sidorovsergei-source/-/DESIGN-NOTES.md

# История решений

1. Исходный запрос: удлиняемый чехол для лезвия и чертёж в четырёх видах. Первый иллюстративный вариант имел условный диапазон 250–330 мм и телескопическую фиксацию; эти размеры не приняты как требования.
2. Пользователь указал изготовление на 3D-принтере. Обсуждались две секции, сменные вставки и фиксация штифтом.
3. Требование расширено до хоккейных, фигурных, детских и вратарских коньков; одних изменений длины недостаточно для универсальной посадки.
4. Назначение уточнено: ходьба, масса пользователя до 130 кг, принтер Ender 3 Pro, последующая продажа.
5. Для прототипа предложена модульная конструкция с металлическими несущими направляющими, корпусом PETG, вставками TPU, резиновой подошвой и удерживающей перемычкой. Прочность не рассчитана и не испытана.
6. Пользователь задал максимум 38 см. В последующих эскизах принят максимум длины лезвия 380 мм, а не внешний габарит чехла.
7. Пользователь предоставил золотой логотип с коронованной головой волка и надписью «Си Ко». В последний эскиз добавлены логотип и место для сменного номера игрока (88 — пример).
8. Пользователь попросил сохранить всё в GitHub. В репозиторий включены доступные PNG и документация; отсутствующие исходники не восстановлены и не подменены новыми изображениями.

9. По запросу пользователя разработан печатный параметрический прототип v0.1 под Ender 3 Pro. Максимальная сборка: две секции 150 мм и средняя 100 мм, наружная длина 400 мм, внутренний размер 380 мм. Добавлены короткие секции 90 мм и средние 20–100 мм.
10. Вместо ещё не рассчитанного телескопического металлического стыка прототип использует две цельные полосы и сменные средние модули. Изменение длины требует другой пары полос. Это изменение явно отмечено; телескопическая функция остаётся для следующей версии.
11. Добавлены TPU-вставки с треугольными фиксирующими рёбрами и соответствующими пазами, пробные подошвы с механическим креплением, отдельные плашки логотипа и номера. Логотип упрощённо восстановлен для печати, исходного вектора нет.
12. При проверке сборки крепёж подошвы уточнён до M3×12: M3×14 мог выступать в основание вставки. STL проверены геометрически; физической печати, проверки посадки и нагрузки не было.

Эти заметки фиксируют обсуждение, а не подтверждают инженерную пригодность предложений.
