sidorovsergei-source/-/drawings/01-modular-guard-380mm.png

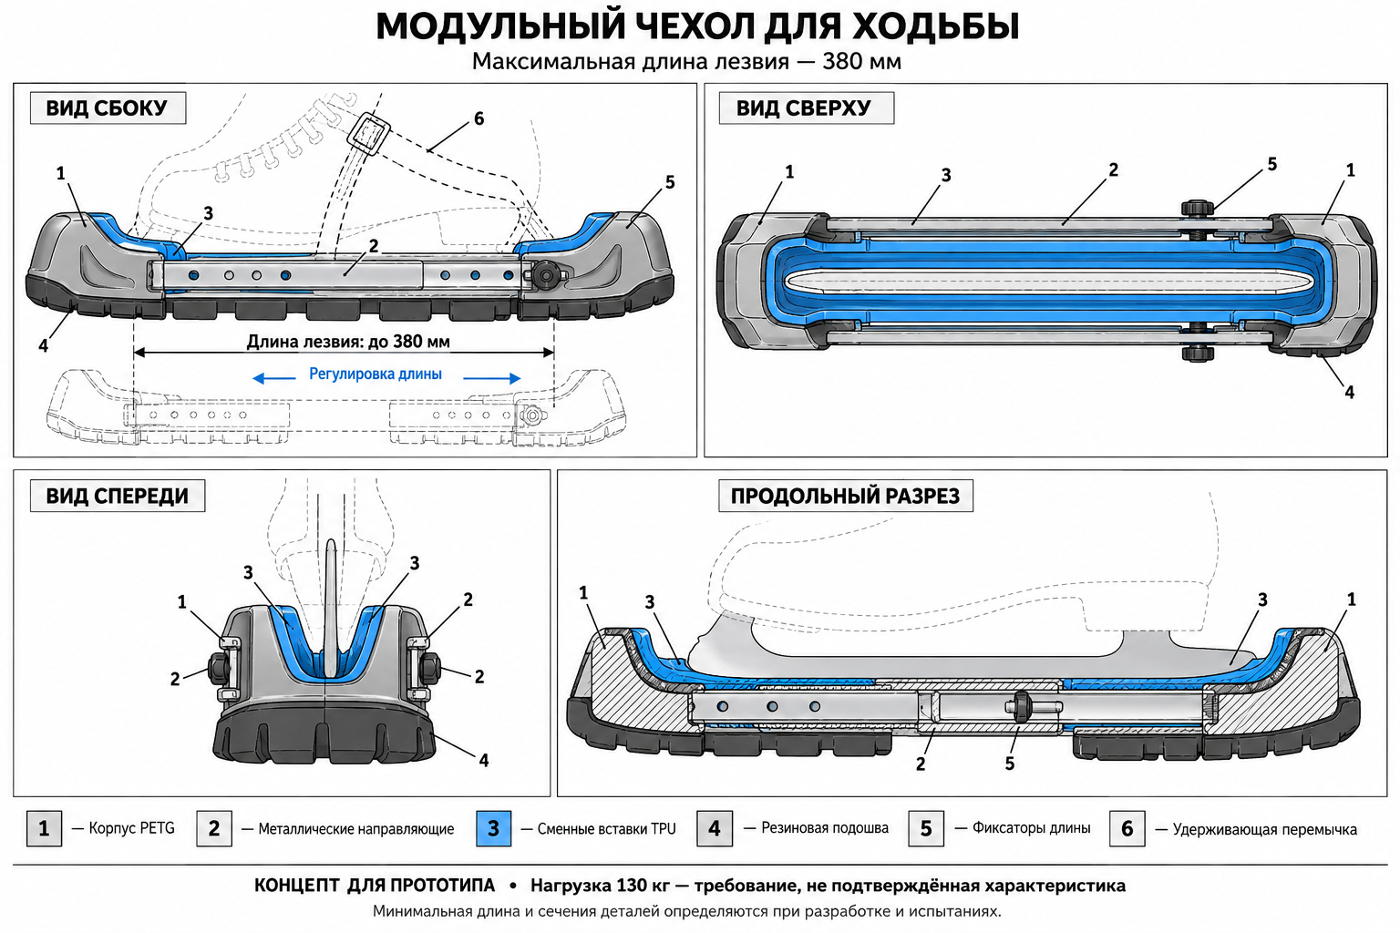
drawings/01-modular-guard-380mm.png
