sidorovsergei-source/-/stl/liner_long.stl

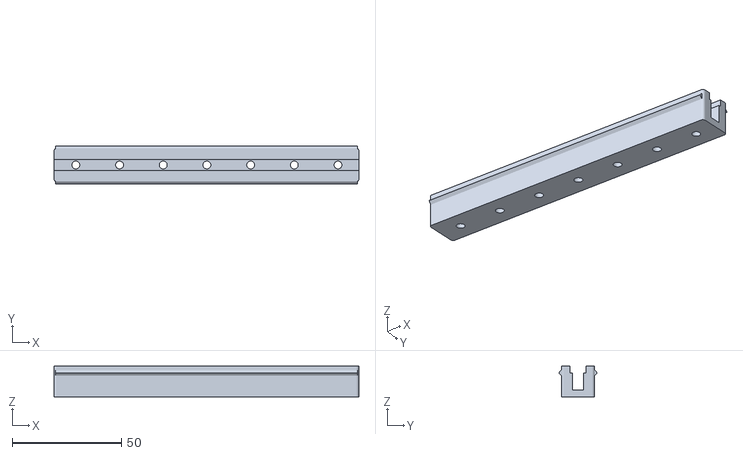
[picture p4: CAD file, 2026-10-10]
stl/liner_long.stl
139.6 x 17.6 x 14.0
