sidorovsergei-source/-/stl/center20.stl

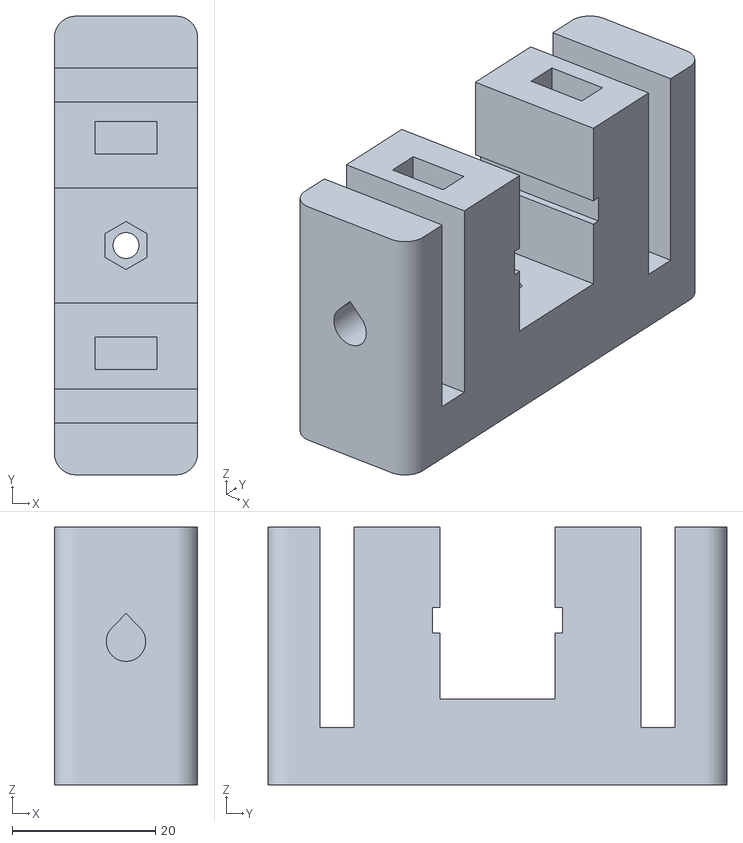
[picture p5: CAD file, 2026-10-10]
stl/center20.stl
20.0 x 64.0 x 36.0
