sidorovsergei-source/-/stl/center40.stl

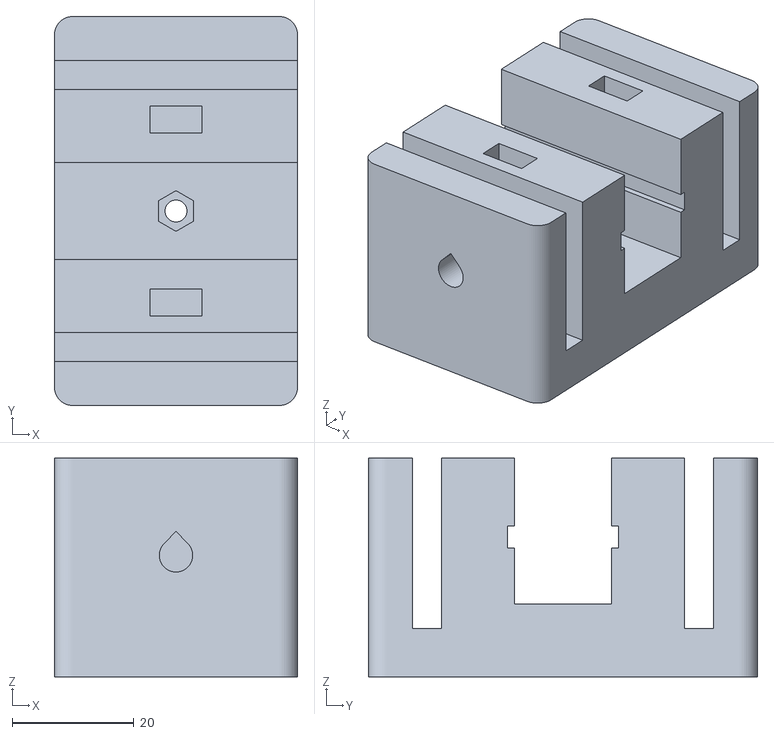
[picture p6: CAD file, 2026-10-10]
stl/center40.stl
40.0 x 64.0 x 36.0
