sidorovsergei-source/-/stl/liner20.stl

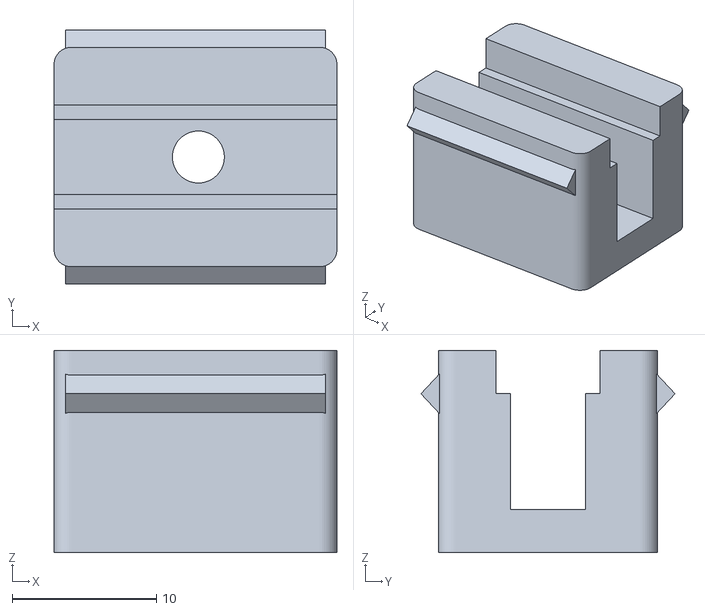
[picture p7: CAD file, 2026-10-10]
stl/liner20.stl
19.6 x 17.6 x 14.0
