sidorovsergei-source/-/stl/logo_badge.stl

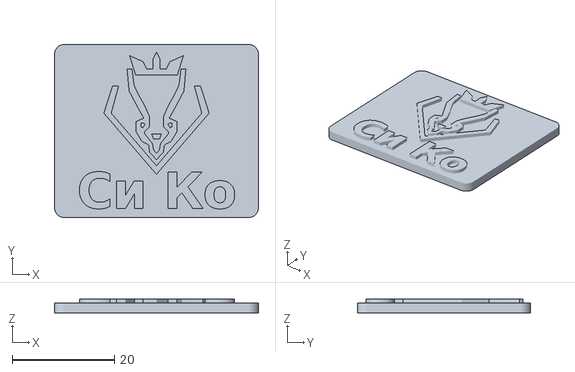
[picture p8: CAD file, 2026-10-10]
stl/logo_badge.stl
40.0 x 34.0 x 2.80
