sidorovsergei-source/-/stl/liner80.stl

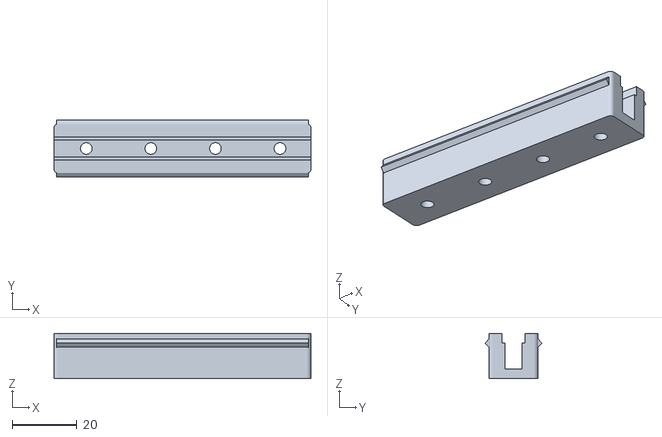
[picture p9: CAD file, 2026-10-10]
stl/liner80.stl
79.6 x 17.6 x 14.0
