sidorovsergei-source/-/stl/sole40.stl

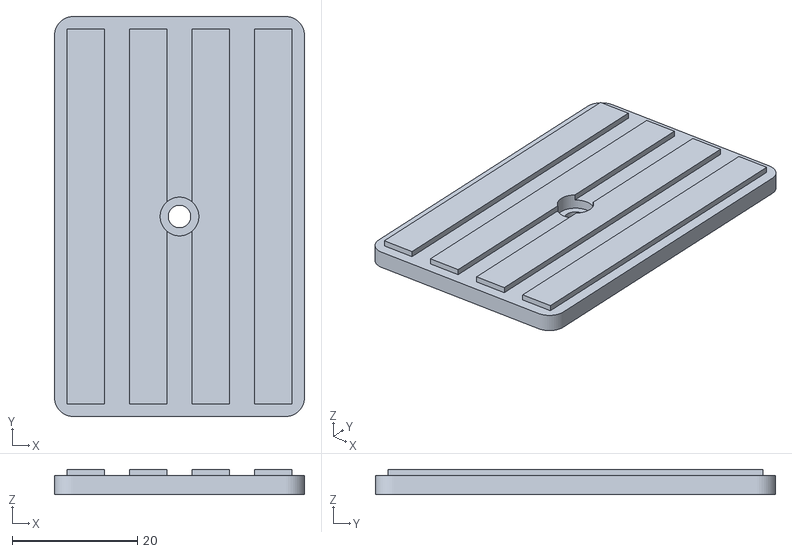
[picture p10: CAD file, 2026-10-10]
stl/sole40.stl
40.0 x 64.0 x 4.00
