sidorovsergei-source/-/stl/sole60.stl

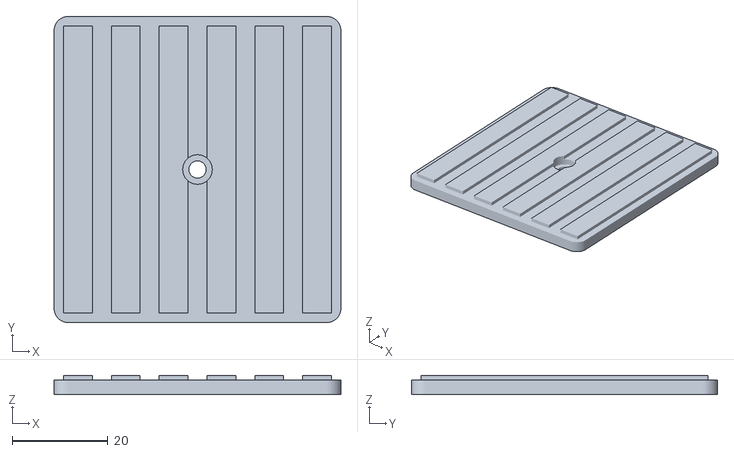
[picture p11: CAD file, 2026-10-10]
stl/sole60.stl
60.0 x 64.0 x 4.00
