sidorovsergei-source/-/stl/liner100.stl

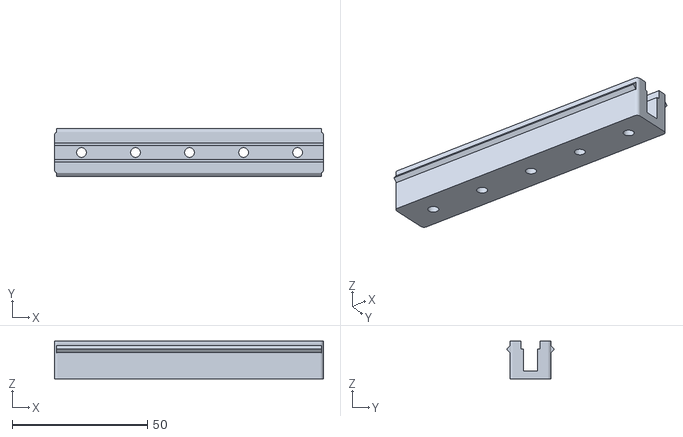
[picture p12: CAD file, 2026-10-10]
stl/liner100.stl
99.6 x 17.6 x 14.0
