sidorovsergei-source/-/stl/liner60.stl

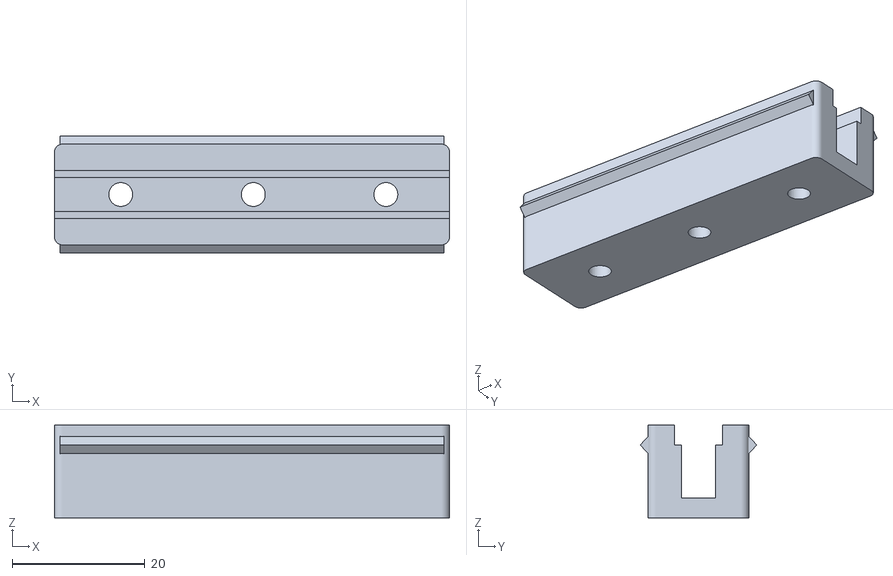
[picture p13: CAD file, 2026-10-10]
stl/liner60.stl
59.6 x 17.6 x 14.0
