sidorovsergei-source/-/stl/sole100.stl

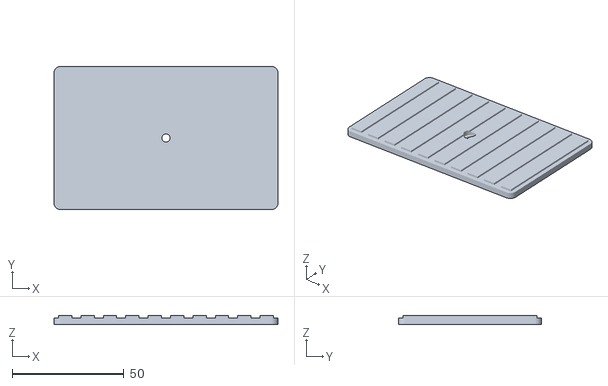
[picture p14: CAD file, 2026-10-10]
stl/sole100.stl
100.0 x 64.0 x 4.00
