sidorovsergei-source/-/stl/body_plate_380.stl

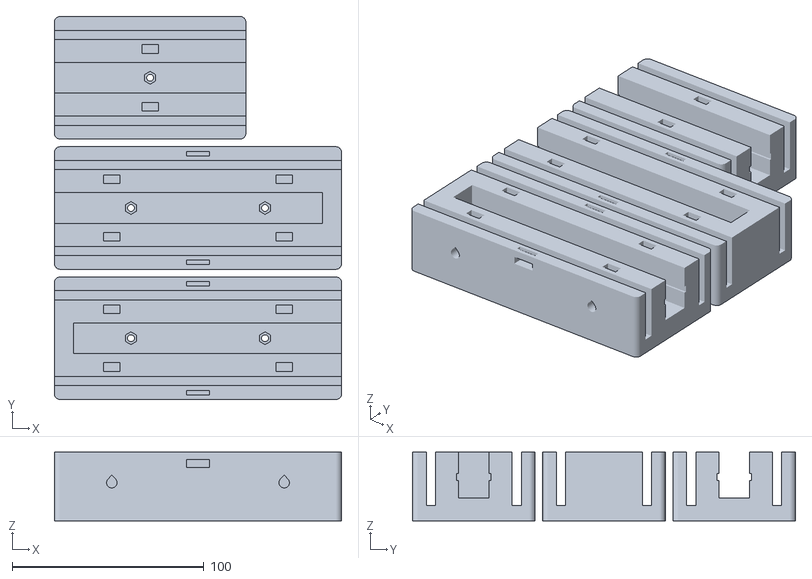
[picture p15: CAD file, 2026-10-10]
stl/body_plate_380.stl
150.0 x 200.0 x 36.0
