sidorovsergei-source/-/stl/center60.stl

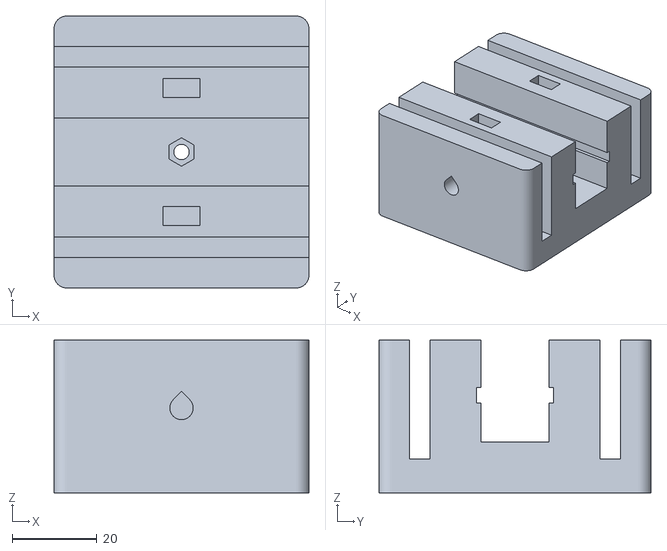
[picture p16: CAD file, 2026-10-10]
stl/center60.stl
60.0 x 64.0 x 36.0
