sidorovsergei-source/-/stl/sole20.stl

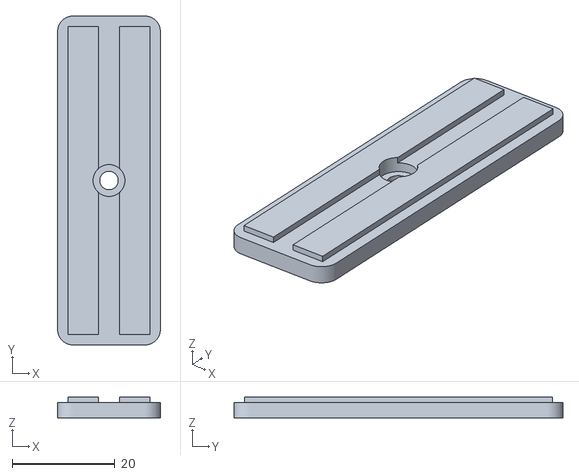
[picture p17: CAD file, 2026-10-10]
stl/sole20.stl
20.0 x 64.0 x 4.00
