sidorovsergei-source/-/stl/sole_long.stl

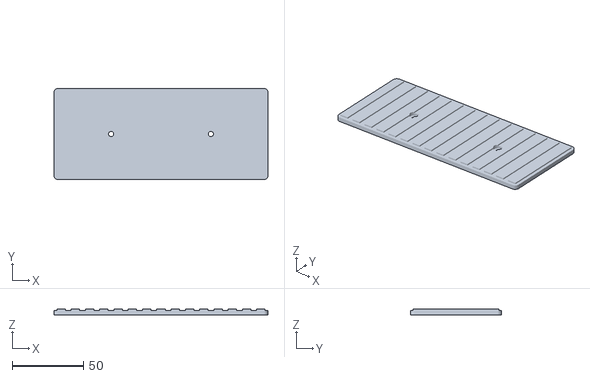
[picture p18: CAD file, 2026-10-10]
stl/sole_long.stl
150.0 x 64.0 x 4.00
