sidorovsergei-source/-/stl/toe_long.stl

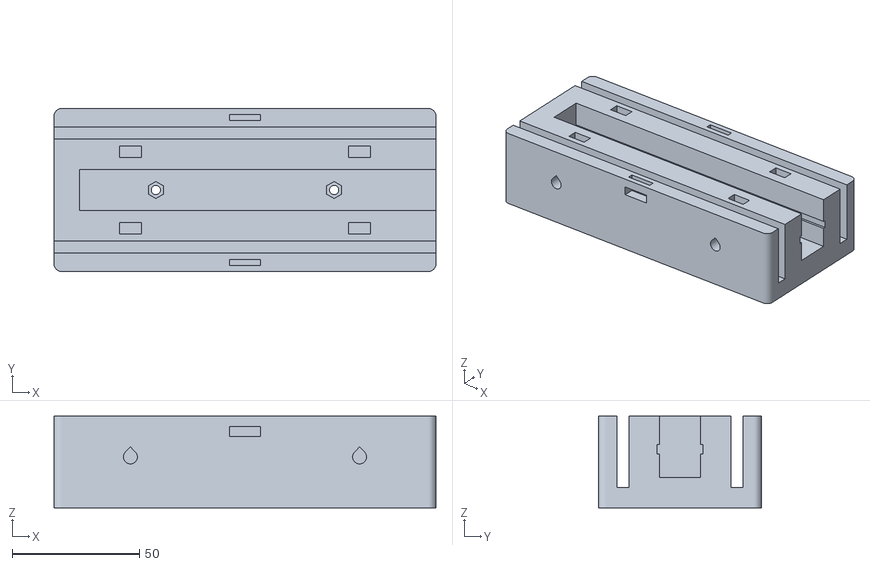
[picture p19: CAD file, 2026-10-10]
stl/toe_long.stl
150.0 x 64.0 x 36.0
