sidorovsergei-source/-/stl/center80.stl

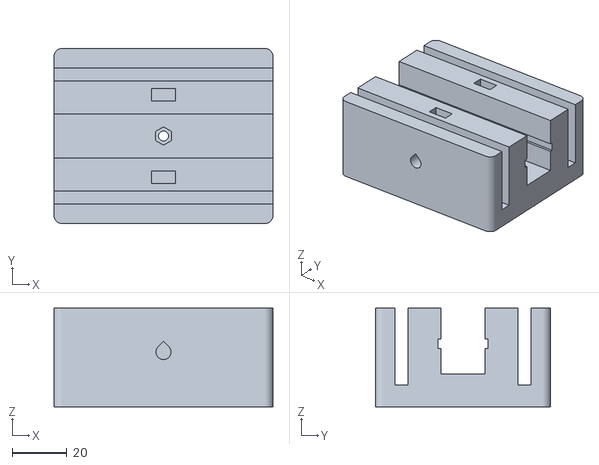
[picture p20: CAD file, 2026-10-10]
stl/center80.stl
80.0 x 64.0 x 36.0
