sidorovsergei-source/-/stl/toe_short.stl

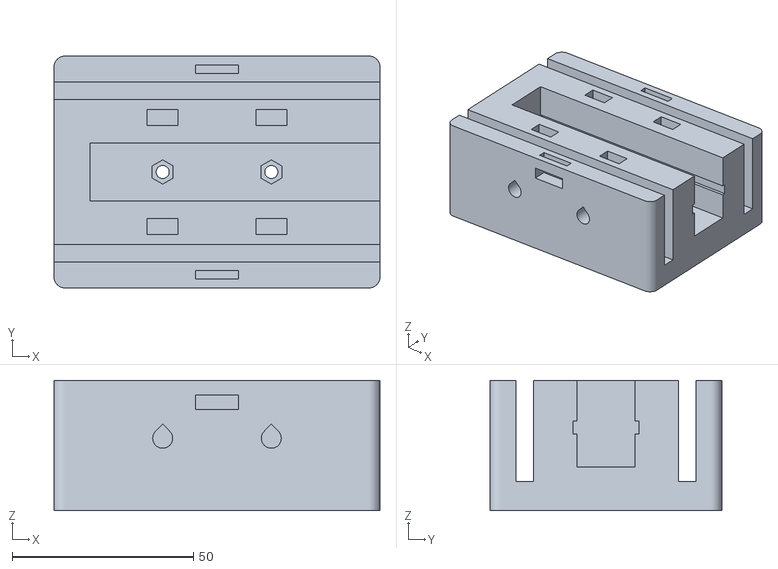
[picture p21: CAD file, 2026-10-10]
stl/toe_short.stl
90.0 x 64.0 x 36.0
