sidorovsergei-source/-/stl/number_badge.stl

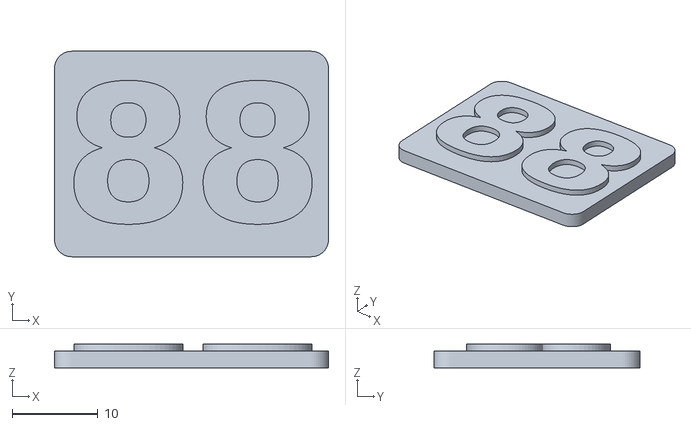
[picture p22: CAD file, 2026-10-10]
stl/number_badge.stl
32.0 x 24.0 x 2.80
