sidorovsergei-source/-/stl/center100.stl

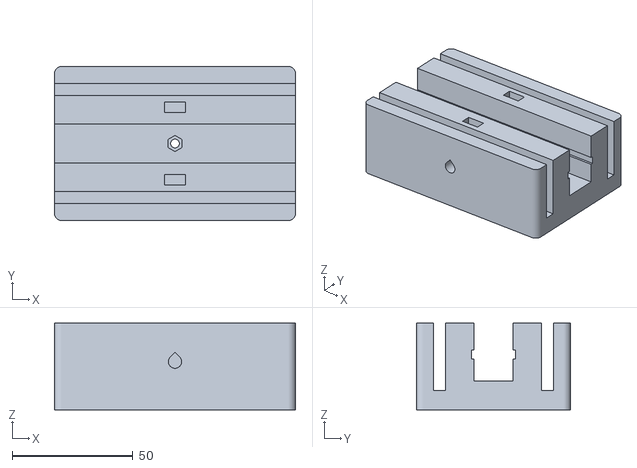
[picture p23: CAD file, 2026-10-10]
stl/center100.stl
100.0 x 64.0 x 36.0
