sidorovsergei-source/-/stl/sole_short.stl

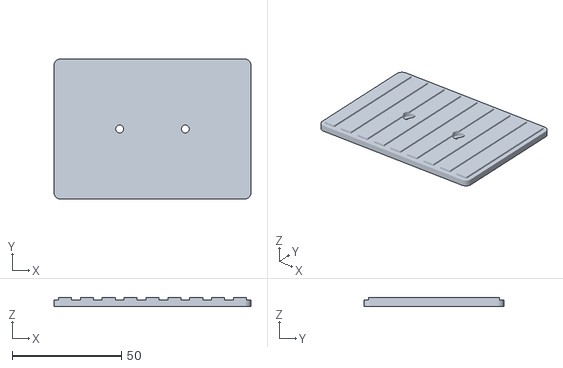
[picture p24: CAD file, 2026-10-10]
stl/sole_short.stl
90.0 x 64.0 x 4.00
