sidorovsergei-source/-/stl/liner40.stl

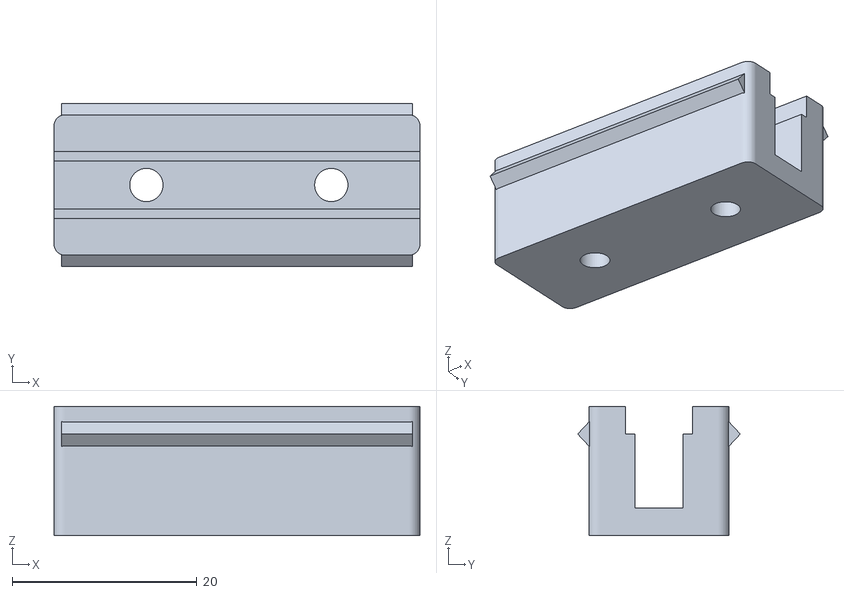
[picture p25: CAD file, 2026-10-10]
stl/liner40.stl
39.6 x 17.6 x 14.0
