sidorovsergei-source/-/stl/sole80.stl

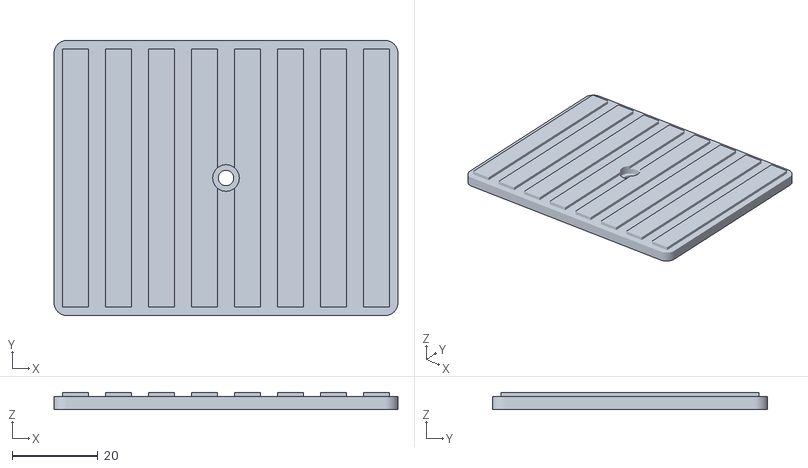
[picture p26: CAD file, 2026-10-10]
stl/sole80.stl
80.0 x 64.0 x 4.00
