sidorovsergei-source/-/(list of files, cad)

Other CAD files:
stl/fit_coupon.stl
stl/liner_short.stl
stl/heel_short.stl
stl/heel_long.stl
