sidorovsergei-source/-/PRINTING.md

# Печать прототипа на Ender 3 Pro

Модель предназначена для изготовления и проверки прототипа модульного чехла. Максимальная длина лезвия по заданию — 380 мм. Масса пользователя 130 кг и совместимость со всеми типами коньков остаются требованиями: испытаний готового изделия пока нет.

Длина меняется заменой средней секции и пары металлических полос соответствующей длины. Собранный чехол не раздвигается: телескопического соединения в этой версии нет. Номинальные внутренние размеры — 160–380 мм с шагом 20 мм; для конкретного лезвия необходимо проверить посадку и удержание, а не выбирать размер только по длине.

Печатные детали не заменяют металлические несущие направляющие, крепёж и подошву. До проверки собранного изделия на стенде не используйте прототип для ходьбы и не обозначайте его как проверенный товар для продажи.

## Принтер и подготовка

- Ender 3 Pro: номинальный объём 220 × 220 × 250 мм. Проверьте полезную область в профиле слайсера, положение прищепок и ограничения конкретной поверхности стола.
- Начальный профиль рассчитан на сопло 0,4 мм и филамент 1,75 мм. Для крупных деталей проверьте, что юбка или кайма также помещается на стол.
- Выставьте стол, проверьте первый слой и откалибруйте подачу филамента. Компенсацию расширения первого слоя подберите на небольшом образце, чтобы нижние края не мешали сборке.
- Просушите материалы по инструкции их производителя. Влажный PETG и TPU дают пузырьки и ухудшают качество поверхности и соединение слоёв.
- Проверьте реальную конструкцию хотэнда. У штатного Ender 3 Pro трубка PTFE обычно подходит к соплу: не превышайте температурные ограничения производителя хотэнда и трубки. Для этого прототипа выбирайте PETG, который печатается в разрешённом диапазоне; высокотемпературный нейлон и композиты требуют отдельной подготовки принтера.

## Комплект для одного чехла максимальной длины

| Деталь | Количество | Размер или назначение |
| --- | --- | --- |
| Длинная передняя секция PETG | 1 | [toe_long.stl](stl/toe_long.stl), 150 × 64 × 36 мм |
| Длинная задняя секция PETG | 1 | [heel_long.stl](stl/heel_long.stl), 150 × 64 × 36 мм |
| Средняя секция PETG | 1 | [center100.stl](stl/center100.stl), длина 100 мм; длина корпуса сборки без декора 400 мм |
| Вкладыши TPU 95A | 2 длинных и 1 средний | [liner_long.stl](stl/liner_long.stl) × 2 и [liner100.stl](stl/liner100.stl) × 1 |
| Подошвенные накладки TPU 95A | 2 длинных и 1 средняя | [sole_long.stl](stl/sole_long.stl) × 2 и [sole100.stl](stl/sole100.stl) × 1; общая толщина 4 мм: основание 3 мм и протектор 1 мм |
| Непрерывные стальные полосы | 2 | 4 × 25 × 376 мм, без острых кромок |
| Декоративные таблички | По желанию | [logo_badge.stl](stl/logo_badge.stl), 40 × 34 мм; [number_badge.stl](stl/number_badge.stl), 32 × 24 мм |
| Винты M5, квадратные гайки и шайбы | По 10 | Примерная длина винта M5 × 20 мм; проверить на фактических гайках и шайбах |
| Винты M3 с низкой полукруглой головкой и шестигранные гайки | По 5 | M3 × 12 мм для механического крепления подошвенных накладок; посадки выполнены под головку типа button head |
| Стропы с пряжками | По одной на торцевую секцию | Покупная стропа шириной 10 мм и толщиной не более 1,5 мм; длина по примерке на конкретном ботинке |

Для пары чехлов удвойте количество. Сечение полосы 4 × 25 мм — геометрический выбор для этого прототипа, а не подтверждённая спецификация для нагрузки 130 кг. Короткие варианты корпуса имеют длину 90 мм; сменные средние секции — 20, 40, 60, 80 и 100 мм. Длина полосы равна наружной длине собранного корпуса минус 24 мм. В торцах предусмотрено по 10 мм под упоры; внутренний продольный размер равен наружной длине минус 20 мм.

Посадочные места квадратных гаек M5 рассчитаны примерно на ширину гайки 8 мм и толщину 3 мм; ширина кармана 8,6 мм, его толщина 4,5 мм. Проверьте размеры реального крепежа до покупки всего комплекта. Винт должен полностью проходить гайку, но его конец не должен касаться вкладыша или лезвия.

Сначала напечатайте [fit_coupon.stl](stl/fit_coupon.stl) из PETG и [liner40.stl](stl/liner40.stl) из TPU. Образец воспроизводит реальные пазы под полосы, крепёж и канал вкладыша на средней секции длиной 40 мм. Проверьте его с обрезками полосы выбранного сечения и фактическими гайками; только после этого печатайте полный комплект.

Вкладыш фиксируется гибкими боковыми выступами в ответных канавках корпуса. Ширина основной посадочной части — 15,2 мм, максимальная ширина вместе с выступами — 17,6 мм. Выступы размещаются на высоте 9,5–12,5 мм от низа вкладыша; после установки им соответствуют канавки на высоте 21,2–24,8 мм от основания корпуса. Номинальный запас до наружной стенки канавки — 0,3 мм. Сначала проверьте защёлкивание и извлечение на пробном комплекте: TPU должен деформироваться упруго, а корпус не должен трескаться. Клей для вкладыша конструкцией не предусмотрен; фактическое удержание после повторной установки и при движении лезвия нужно подтвердить экспериментально.

Самая большая жёсткая деталь занимает 150 × 64 × 36 мм. Она помещается на номинальном столе Ender 3 Pro отдельно с каймой. Печатайте крупные корпуса по одному: это позволяет оценить качество и не потерять весь комплект при остановке печати.

После проверки отдельных деталей можно использовать [body_plate_380.stl](stl/body_plate_380.stl): это один STL с тремя раздельными жёсткими секциями для одного чехла на 380 мм. Габарит раскладки 150 × 200 × 36 мм; с каймой 5 мм — примерно 160 × 210 мм. Между деталями предусмотрено 4 мм: слайсер может объединить соседние каймы, после печати их нужно удалить. Печатайте всю раскладку только из PETG. Мягкие вкладыши и подошвы печатаются отдельно из TPU; файл раскладки не является готовым собранным чехлом.

## Материалы

| Детали | Материал | Что купить для первого комплекта |
| --- | --- | --- |
| Жёсткие части корпуса, декоративные таблички | PETG | Обычный PETG без наполнителя, чёрный; небольшой запас золотого PETG для декора |
| Мягкие вкладыши канала лезвия | TPU 95A | TPU с рекомендацией производителя для подачи Bowden |
| Пробная подошва | TPU 95A | STL-накладки для проверки геометрии и крепления |
| Подошва готового изделия | Материал с проверенным сцеплением | Включая возможную замену на подошвенную резину после разработки крепления и испытаний |
| Несущие направляющие и фиксаторы | Металл | По размерам и спецификации конкретной сборки; не печатать как замену металлическим деталям |

TPU 95A можно использовать для пробных мягких деталей. Его твёрдость и текстура сами по себе не подтверждают сцепление на мокром полу. PLA не используйте как материал ходового прототипа.

## Начальные настройки слайсера

Это отправная точка для настройки конкретного филамента и принтера, а не подтверждение несущей способности изделия.

| Параметр | PETG, корпус | TPU 95A, вкладыши и подошвы |
| --- | --- | --- |
| Диаметр сопла | 0,4 мм | 0,4 мм |
| Высота слоя | 0,20 мм | 0,20 мм |
| Ширина линии | 0,45–0,48 мм | 0,42–0,45 мм |
| Стенки | 6 линий | 4 линии |
| Верх и низ | Не менее 1,2–1,6 мм | Не менее 1,0 мм |
| Заполнение | 40–60%, gyroid или cubic | 100% для тонких деталей |
| Температура сопла | Начать с 230–235 °C, если разрешено для материала и хотэнда | По инструкции производителя TPU, в пределах возможностей хотэнда |
| Температура стола | Начать с 70 °C, с учётом допустимого режима поверхности | По инструкции производителя, обычно 40–60 °C |
| Скорость | 30–40 мм/с; внешние стенки 20–25 мм/с | 15–20 мм/с |
| Первый слой | 15–20 мм/с | 10–15 мм/с |
| Обдув | Слабый после первых слоёв, настроить по сцеплению слоёв | По инструкции производителя TPU |
| Ретракт | Откалиброванный для PETG и Bowden | Начать без ретракта, затем подобрать минимально необходимый |
| Адгезия к столу | При необходимости кайма 5–8 мм | При необходимости небольшая кайма |

Перед полноразмерной печатью проверьте посадку вкладыша, соединение корпуса и крепёж на небольшой пробной детали. Зазоры зависят от первого слоя, подачи и усадки; не уменьшайте сечения несущих участков для получения более свободной посадки.

PETG может слишком прочно прилипать к некоторым поверхностям. Используйте рекомендованный производителем разделительный слой и снимайте деталь после остывания стола.

На штатной системе подачи Bowden гибкий TPU может застревать и наматываться на шестерню. Для первого опыта используйте TPU 95A, снижайте скорость и давление прижимного ролика в допустимых пределах; более мягкий TPU не заменяет выбранный материал без повторной настройки и проверки.

## Ориентация и декоративные детали

Корпуса печатайте плоским основанием на столе, каналом для лезвия вверх. Вкладыши печатайте плоским низом вниз, открытым каналом вверх. Подошвенные накладки размещайте плоской поверхностью к столу, протектором вверх. Детали спроектированы для печати в этих ориентациях без поддержек; перед запуском проверьте мосты над боковыми отверстиями в предпросмотре. Не поворачивайте деталь только ради заполнения стола: изменение направления слоёв изменяет прочность.

Сменные таблички печатайте задней плоскостью на столе, рельефом вверх. Основа толщиной 2 мм, рельеф высотой 0,8 мм. Для золотого рельефа на чёрной основе используйте паузу и ручную замену PETG после печати основы, перед первым слоем рельефа выше 2 мм. Задавайте её по фактическому слою в предпросмотре слайсера; начальная высота первого слоя может изменить номер слоя. Совместимость команды паузы с прошивкой Ender сначала проверьте на маленькой табличке; после замены уберите вытекший пластик и убедитесь, что печать продолжится без смещения.

Логотип — упрощённая реконструкция присланного изображения, адаптированная к соплу 0,4 мм; исходного векторного файла в репозитории нет. Таблички приклеиваются к переднему и заднему торцам корпуса и не участвуют в несущем соединении. Не закрывайте ими крепёж, прорези строп или доступ к металлическим полосам. Номер 88 в комплекте является примером; для другого номера нужно заново экспортировать соответствующую модель.

## Подбор канала лезвия и номера

В [исходнике модели](cad/skate_guard.scad) изменяются параметры `blade_thickness`, `blade_side_clearance` и `player_number`. По умолчанию заданы толщина лезвия 3,2 мм и пробный зазор по 1 мм на сторону: канал получается шириной 5,2 мм. Это начальная геометрия для примерки, она не обеспечивает плотную посадку любого лезвия. Измерьте собственное лезвие штангенциркулем и проверьте его в пробном вкладыше. Мягкость TPU изменяет посадку, но не заменяет проверку удержания.

Для самостоятельного экспорта через OpenSCAD можно выполнить, например:

```bash
openscad -o liner40-custom.stl -D 'part="liner40"' -D 'blade_thickness=3.2' -D 'blade_side_clearance=0.5' cad/skate_guard.scad
openscad -o number-17.stl -D 'part="number_badge"' -D 'player_number="17"' cad/skate_guard.scad
```

Первый пример показывает способ изменения параметров, а не рекомендуемый окончательный зазор. Для полноразмерной сборки нужно экспортировать все используемые вкладыши с одинаковыми выбранными параметрами. Для нестандартного числа проверьте, что рельеф помещается на табличке и полностью печатается соплом 0,4 мм.

## Проверка перед сборкой

1. В слайсере проверьте размер каждой детали и наличие всех стенок. STL не содержит единиц измерения: при импорте используйте миллиметры.
2. Убедитесь, что первый слой, отверстия и вырезы не исчезли в предпросмотре; тонкие элементы логотипа должны образовывать печатные линии.
3. Уберите кайму и заусенцы. Детали с трещинами, расслоением или заметными пропусками подачи не используйте в сборке.
4. Проверьте соединение без лезвия. Оно должно собираться без удара и чрезмерного усилия, а фиксаторы — полностью вставляться и удерживаться от выпадения.
5. Проверьте посадку на конкретном лезвии вручную, без нагрузки человеком. Убедитесь, что зубцы фигурного конька не упираются в дно неподходящей вставки и что металл лезвия не касается крепежа.

## Подготовка металлических полос и сборка

1. Сначала напечатайте и проверьте посадку всех жёстких секций. Для варианта на 380 мм соедините в линию переднюю секцию 150 мм, среднюю 100 мм и заднюю 150 мм.
2. Подготовьте две ровные стальные полосы 4 × 25 × 376 мм. Уберите заусенцы и острые кромки после резки и сверления, скруглите торцы. В каждой полосе нужны пять сквозных отверстий диаметром 5,5 мм через толщину 4 мм; их расположение сверяйте с фактически напечатанными секциями. Торцы полос расположены на 12 мм внутри корпуса. При необходимости можно подобрать покупные защитные накладки, которые не участвуют в передаче нагрузки и не мешают сборке; STL таких накладок в комплект не входит.
3. Для указанной сборки центры отверстий находятся на расстояниях 18, 108, 188, 268 и 358 мм от переднего торца полосы, на высоте 12 мм от её нижней длинной кромки. Это разметка только для комбинации 150 + 100 + 150 мм. Другая комбинация секций требует другой длины и разметки полос.
4. Вставьте квадратные гайки M5 в верхние карманы боковых стенок. Установите полосы в открытые сверху боковые пазы: ширина паза 4,8 мм, нижняя опора находится на высоте 8 мм от основания корпуса. Полосы должны соединять все секции непрерывно.
5. Совместите боковые отверстия корпуса и полос. Установите десять винтов M5 с шайбами для варианта со средней секцией: по два крепления на каждом конце и одно на средней секции для каждой полосы. Затягивайте равномерно; не сминайте PETG. Момент затяжки и способ защиты от отвинчивания нужно подтвердить на испытаниях.
6. До установки вкладышей вставьте гайки M3 в открытые из канала лезвия карманы. Приложите подошвенные накладки снизу, протектором к полу, и закрепите пятью винтами M3 × 12 мм с низкой полукруглой головкой. Под головки предусмотрены цилиндрические выборки диаметром 6,2 мм. Головки должны находиться ниже поверхности протектора и не касаться пола; потайные винты не являются прямой заменой. При номинальной геометрии конец винта M3 × 12 мм находится на высоте 10,6 мм от основания корпуса, ниже опорной поверхности вкладыша на высоте 12 мм. Проверьте эту границу с фактическими головками, гайками и напечатанной подошвой: конец каждого винта должен оставаться ниже основания вкладыша. M3 × 14 мм в данной сборке не используйте — он выступает до высоты 12,6 мм и может упереться во вкладыш.
7. Вставьте мягкие вкладыши сверху до посадки боковых гибких выступов в ответные канавки корпуса. Проверьте фиксацию без удара и отсутствие контакта с концами винтов; каждую секцию вкладыша проверьте на вытягивание вручную. Отдельного профилированного кармана для зубцов фигурных коньков в этой версии нет. Если зубцы мешают посадке, нужен другой вкладыш или корпус; не считайте такой конёк совместимым.
8. Проденьте покупные стропы через верхний вход и боковой выход прорезей на каждой торцевой секции. Подберите длину и расположение пряжки по конкретному ботинку: стропа должна удерживать чехол при подъёме ноги и не оставлять свободную петлю под подошвой. Проверяйте эту схему на неподвижной сборке; геометрия прорезей не подтверждает удержание любого ботинка.
9. Приклейте декоративные таблички к плоским наружным торцевым стенкам между скруглёнными краями. Таблички не должны выступать выше корпуса или закрывать верхний вход лезвия. Их толщина увеличит внешний продольный габарит, но не внутреннюю длину посадки. Дождитесь полного отверждения выбранного клея по его инструкции. Декоративный клей не заменяет винты или металлические полосы.

Если отверстия не совпали, остановите сборку и проверьте усадку, размеры и разметку. Не расширяйте несущие посадочные места до свободного люфта. При изменении длины используйте пару полос, рассчитанных на новую сборку; не соединяйте короткие полосы встык и не заменяйте их печатными перемычками.

## Что проверить до ходьбы и продажи

Проверьте непрерывную опору под лезвием, фиксацию регулировки и удержание при подъёме конька. Два независимых соединения, несовместимые лезвия и диапазон малых размеров требуют отдельных проверок. Двухполозные детские коньки не следует считать совместимыми автоматически.

На стенде проверьте статическую и повторную нагрузку, перекос, удар, износ соединения и удержание подошвы. Нагрузка при шаге может превышать вес человека; один только неподвижный груз массой 130 кг не подтверждает пригодность для ходьбы.

Проверьте сцепление подошвы на сухих и мокрых покрытиях, а также после загрязнения и охлаждения. Зафиксируйте материал, настройки, размеры и результаты каждого образца. Для продажи понадобятся обоснованные ограничения нагрузки и совместимости, воспроизводимый контроль качества и инструкция по использованию.
